rjsears/Pool_Fill_Control/pictures/atlas_usb_ph_orp_interface.jpg

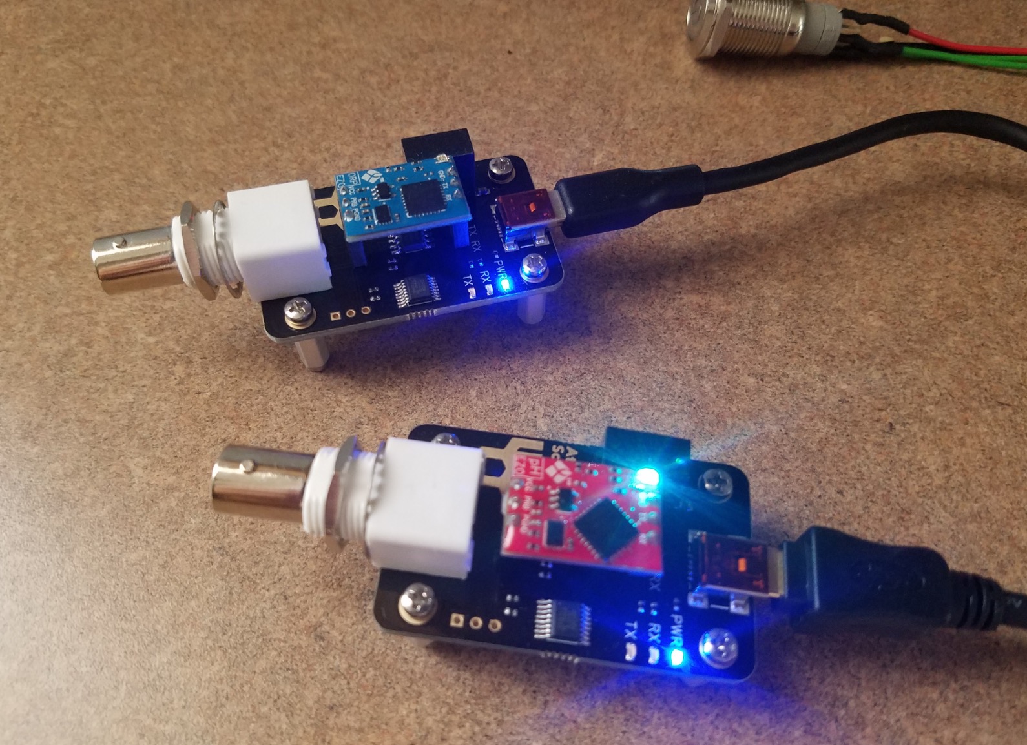
pictures/atlas_usb_ph_orp_interface.jpg
