rjsears/Pool_Fill_Control/pictures/bb_mockup.jpg

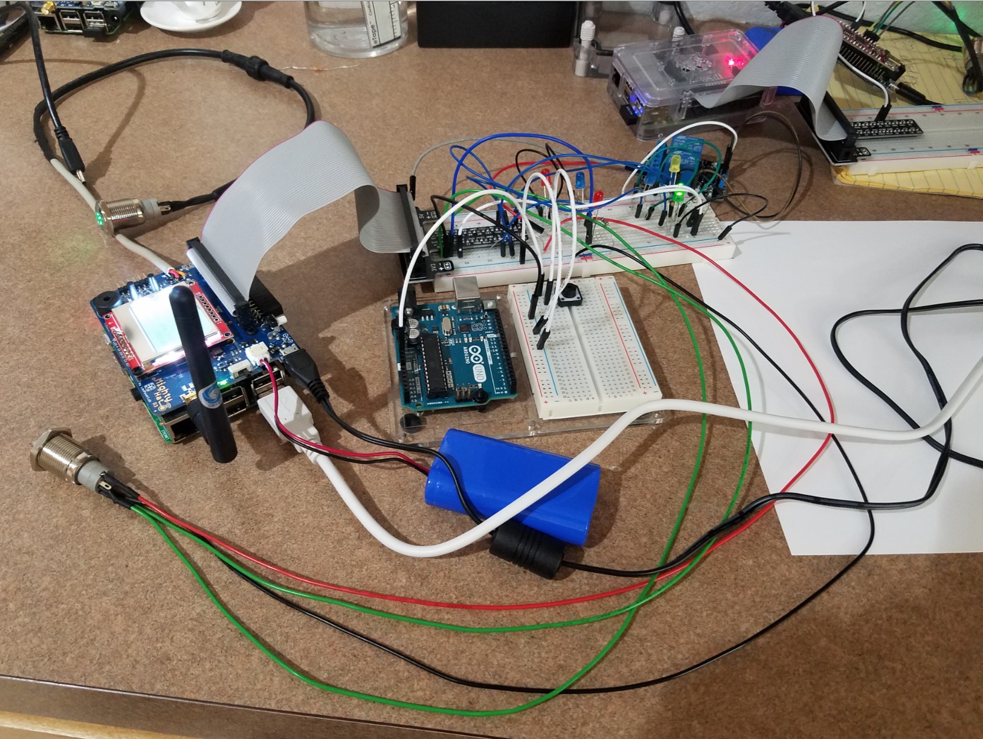
pictures/bb_mockup.jpg
