rjsears/Pool_Fill_Control/pictures/emonTH.jpg

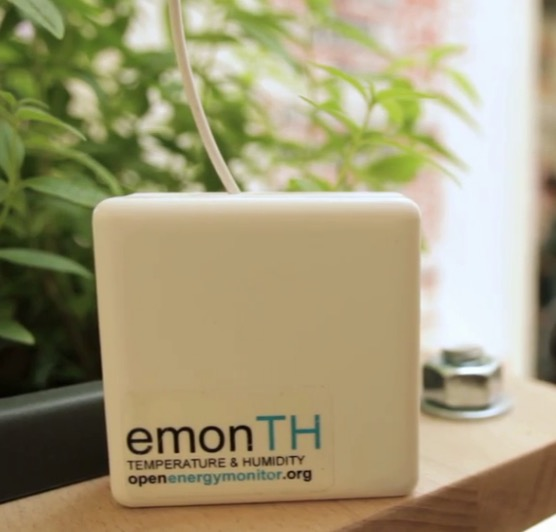
pictures/emonTH.jpg
