rjsears/Pool_Fill_Control/pictures/etape.jpg

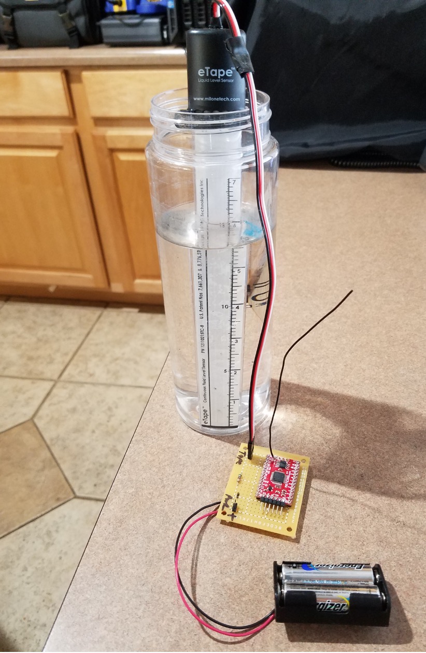
pictures/etape.jpg
