rjsears/Pool_Fill_Control/pictures/interface_board_back.jpg

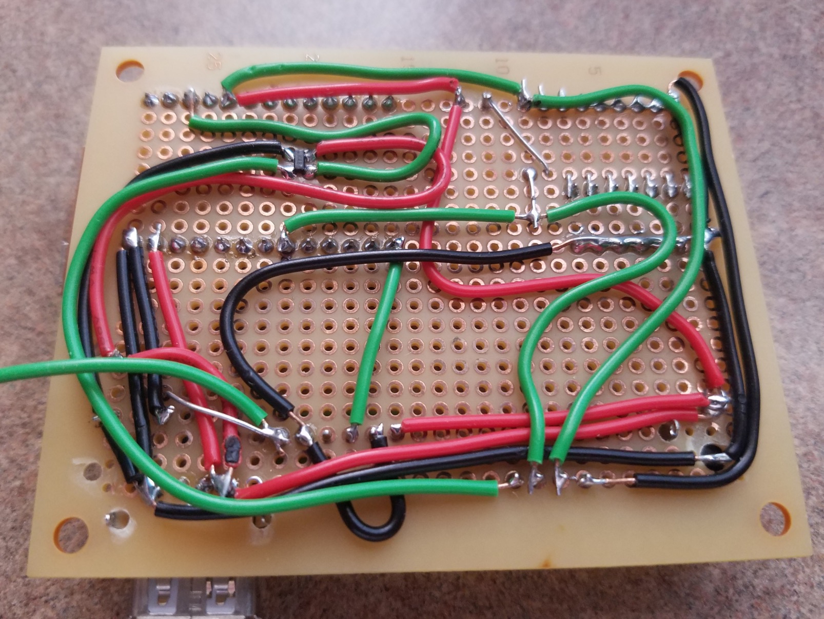
pictures/interface_board_back.jpg
