rjsears/Pool_Fill_Control/pictures/interface_board_front.jpg

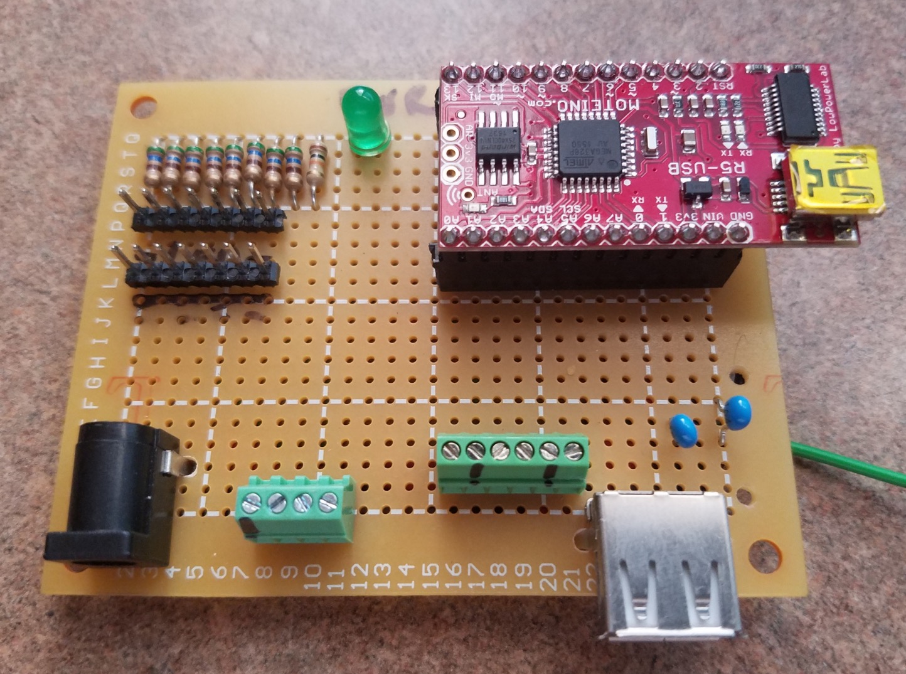
pictures/interface_board_front.jpg
