rjsears/Pool_Fill_Control/pictures/IO_Board_v1.jpg

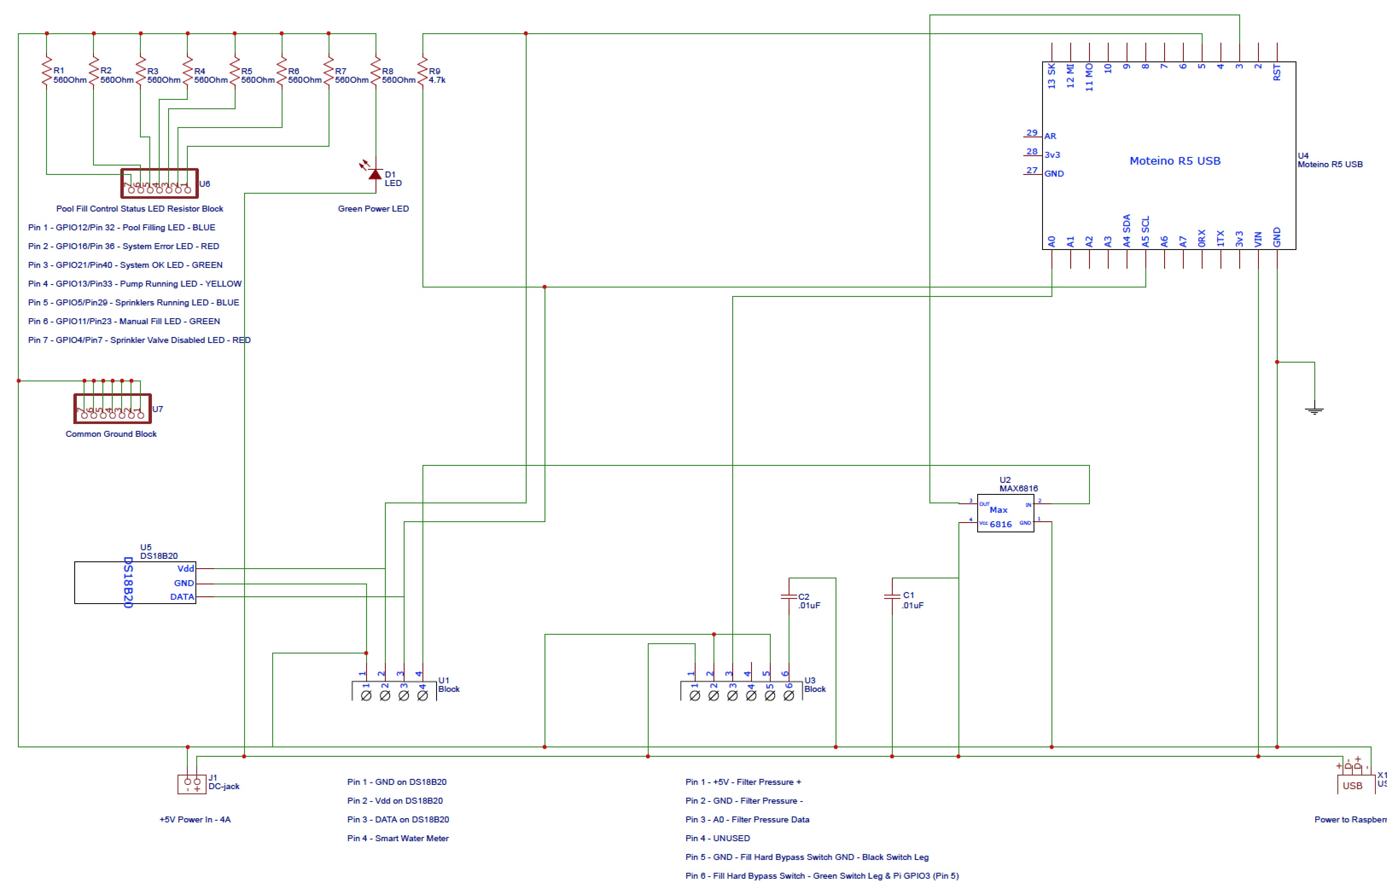
pictures/IO_Board_v1.jpg
