rjsears/Pool_Fill_Control/pictures/PFC_external.jpg

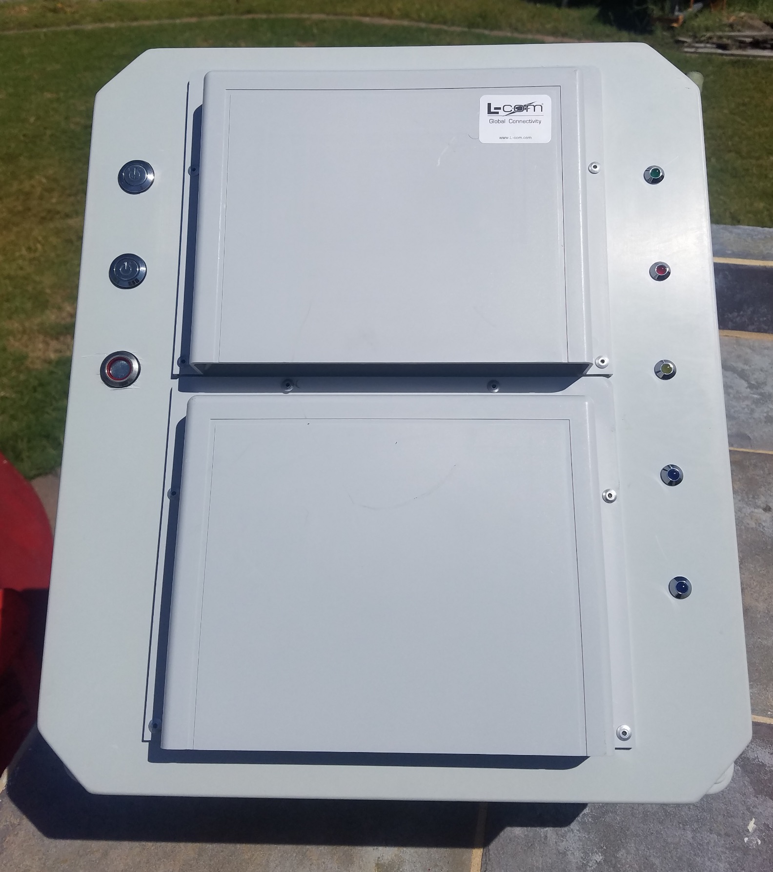
pictures/PFC_external.jpg
