rjsears/Pool_Fill_Control/pictures/PFC_fans.jpg

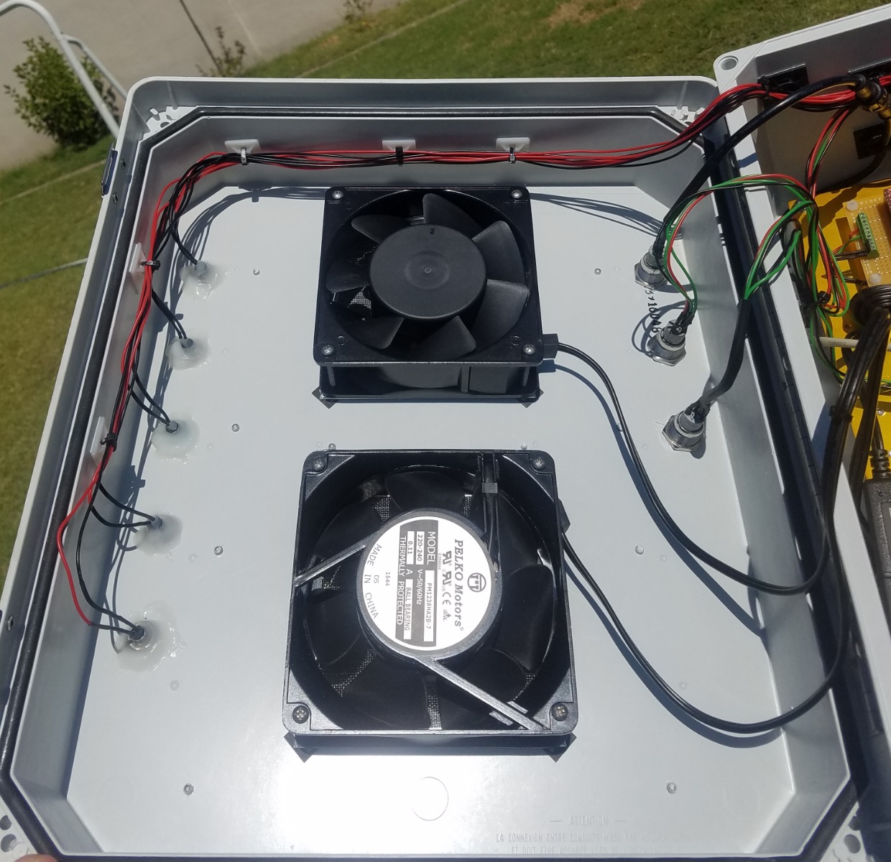
pictures/PFC_fans.jpg
