rjsears/Pool_Fill_Control/pictures/PFC_internal.jpg

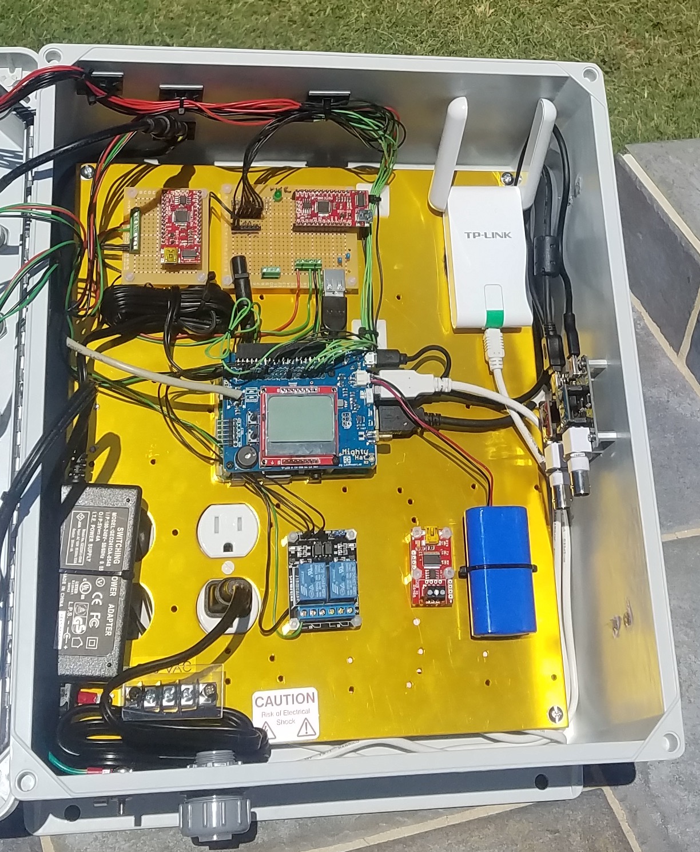
pictures/PFC_internal.jpg
