rjsears/Pool_Fill_Control/pictures/PFC_lights.jpg

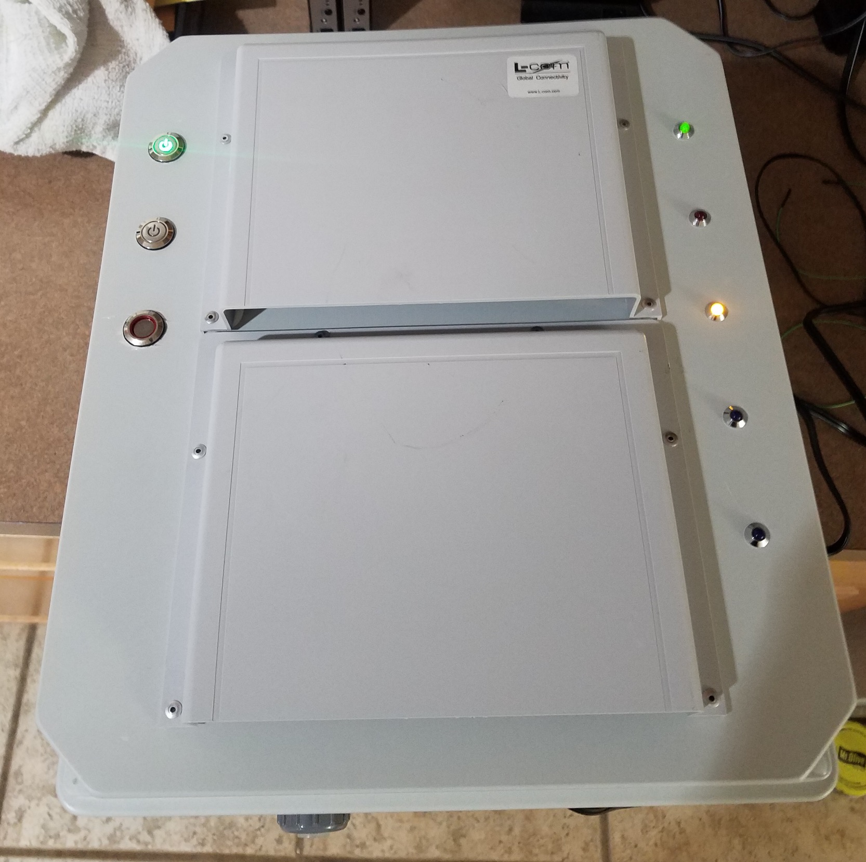
pictures/PFC_lights.jpg
