rjsears/Pool_Fill_Control/pictures/pool_control_web_interface_v32.jpg

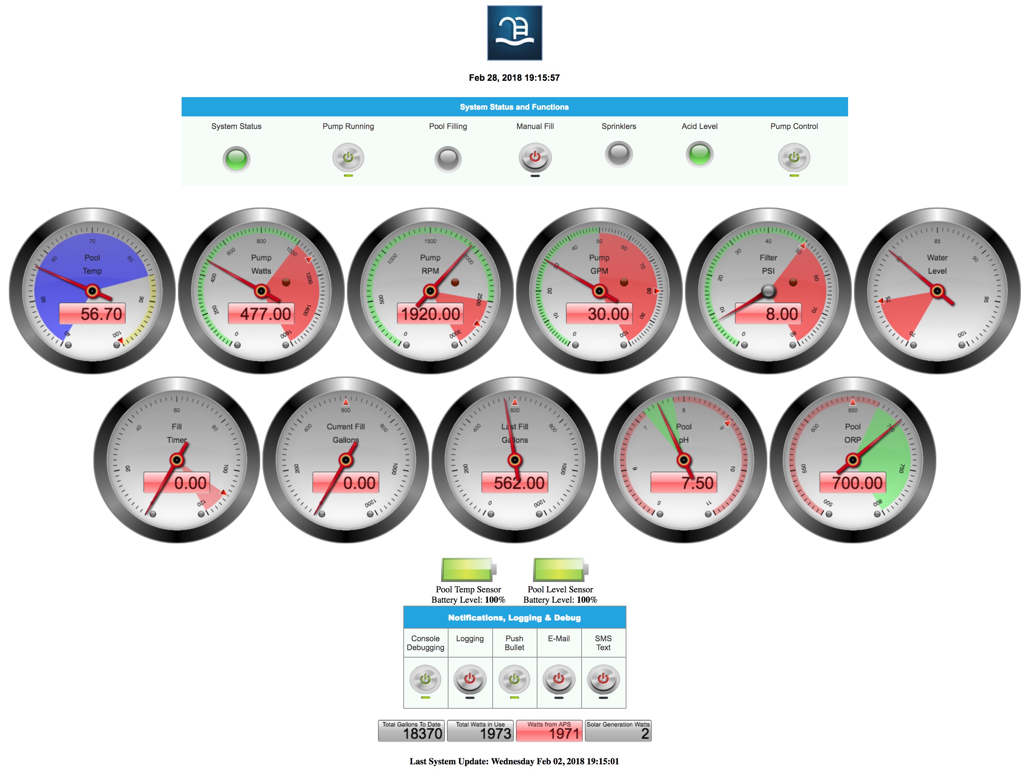
pictures/pool_control_web_interface_v32.jpg
