rjsears/Pool_Fill_Control/pictures/pool_fill_valve_complete.jpg

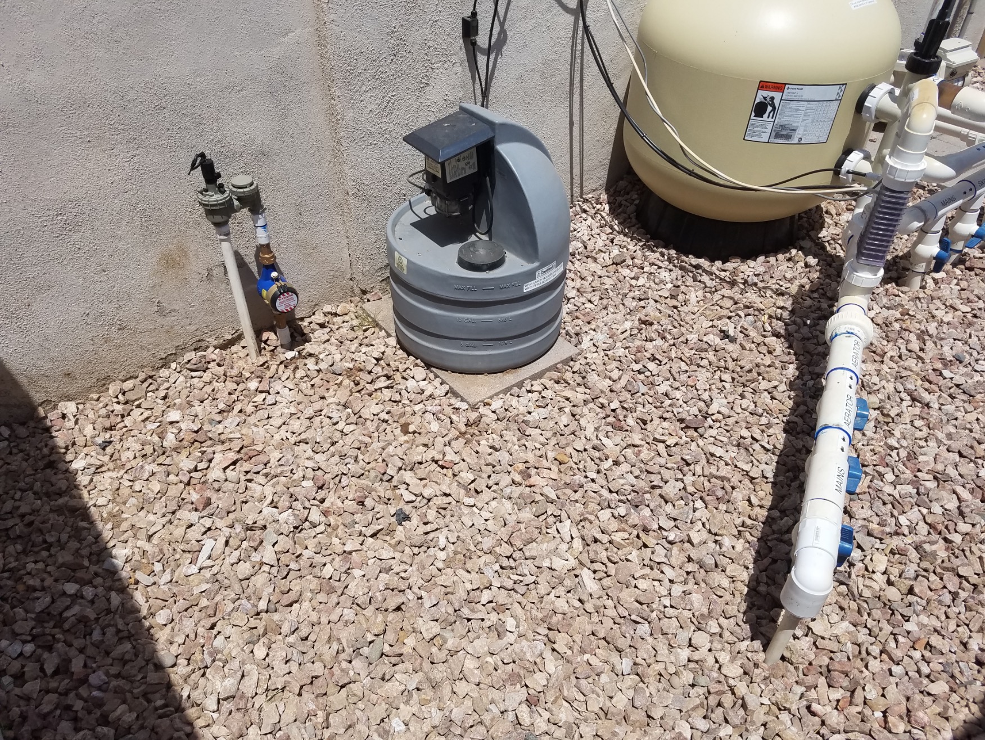
pictures/pool_fill_valve_complete.jpg
