rjsears/Pool_Fill_Control/pictures/pool_fill_valve_in_process1.jpg

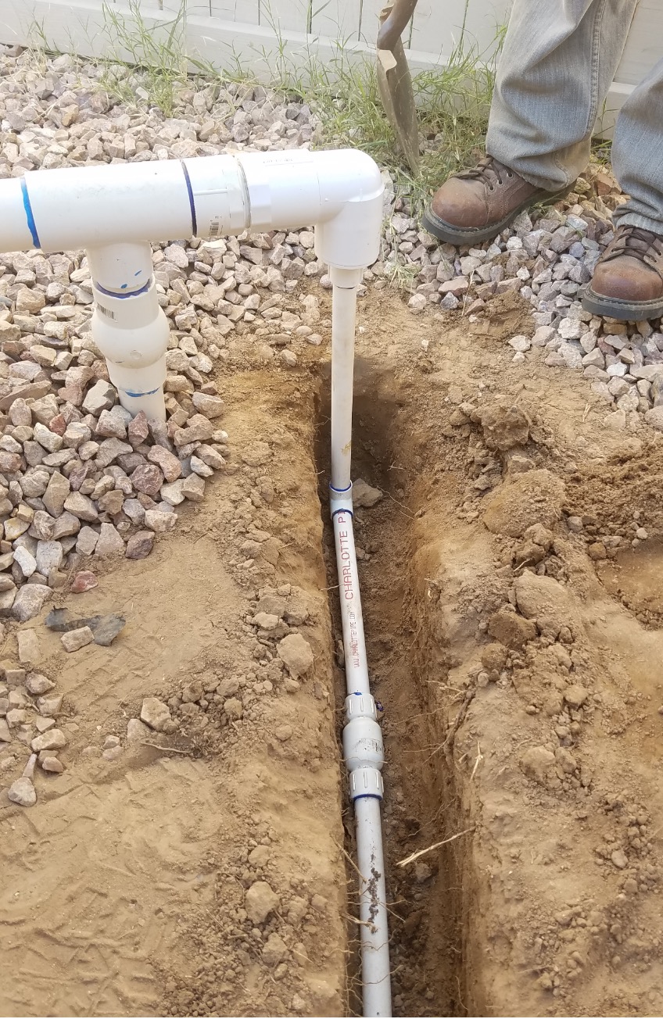
pictures/pool_fill_valve_in_process1.jpg
