rjsears/Pool_Fill_Control/pictures/pool_fill_valve_in_process.jpg

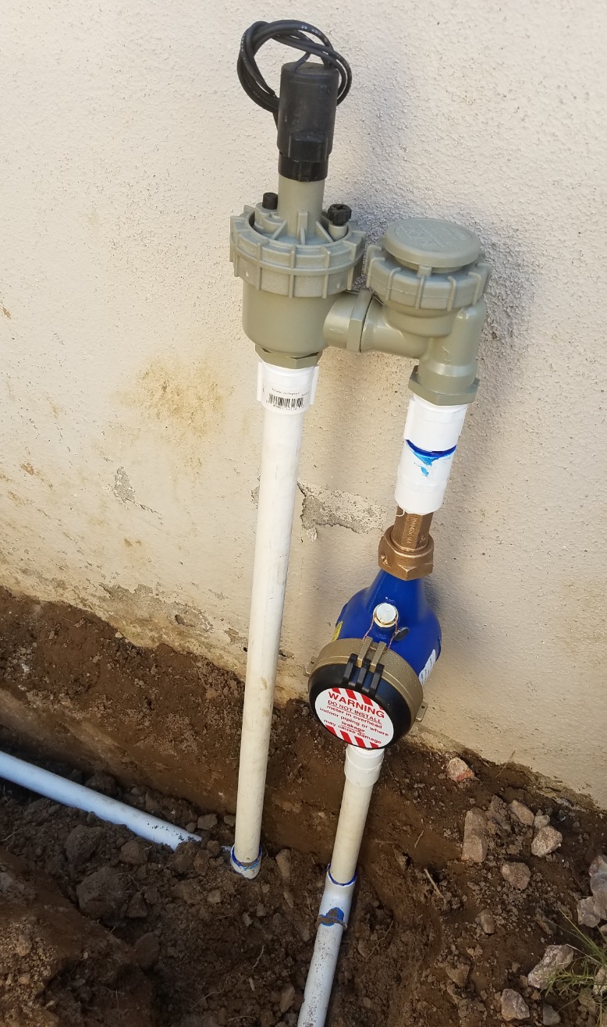
pictures/pool_fill_valve_in_process.jpg
