rjsears/Pool_Fill_Control/pictures/pool_filter_area.jpg

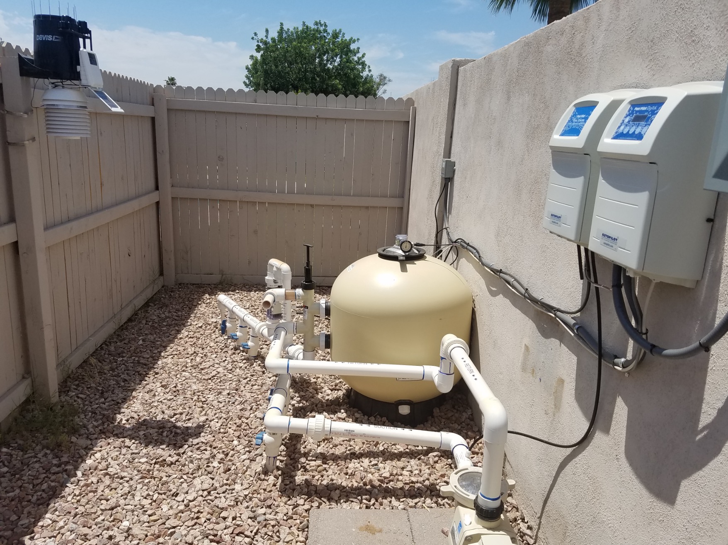
pictures/pool_filter_area.jpg
