rjsears/Pool_Fill_Control/pictures/schematic.jpg

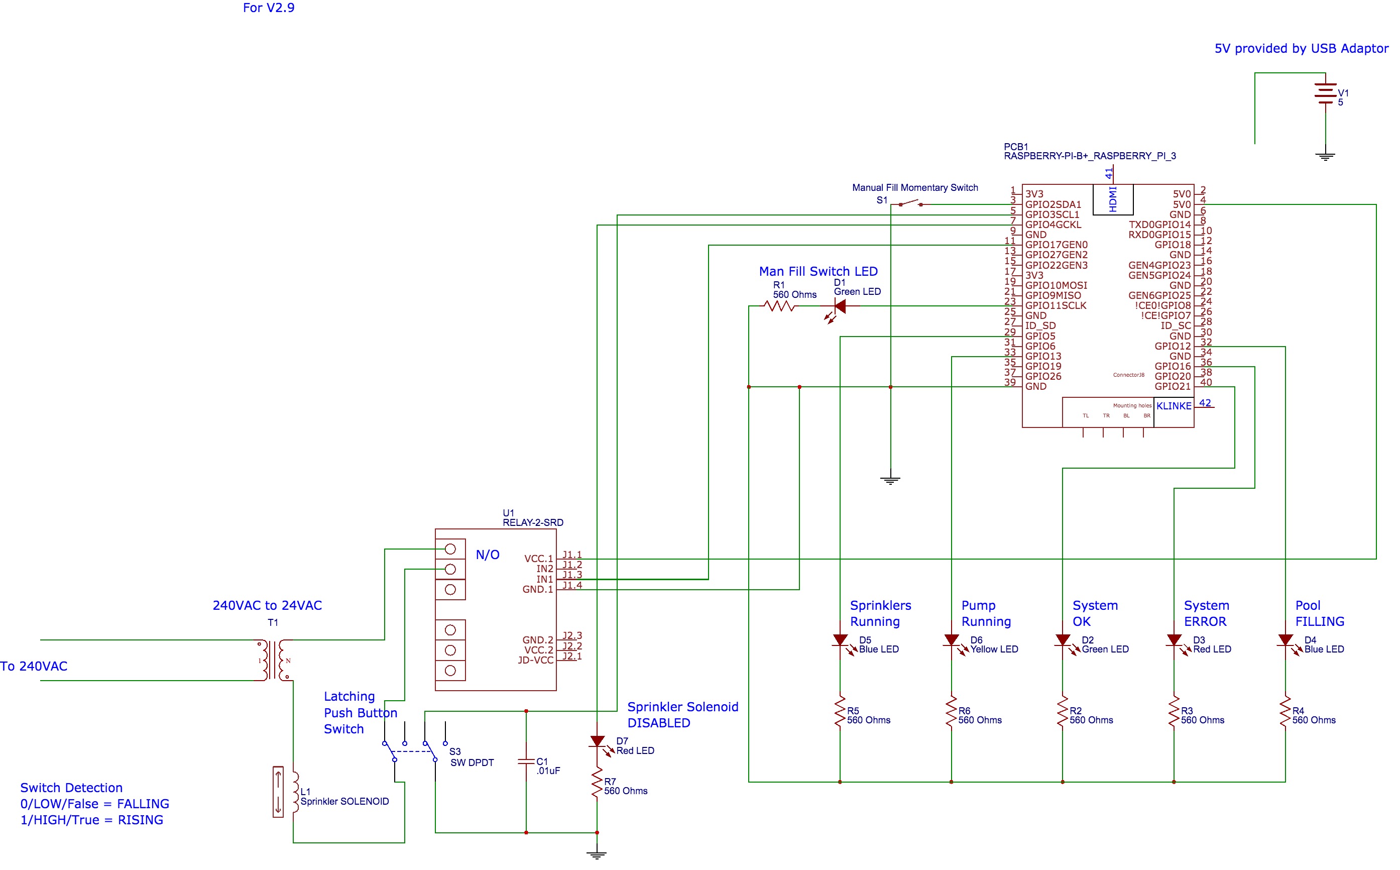
pictures/schematic.jpg
