rjsears/Pool_Fill_Control/pictures/schematic_V2.jpg

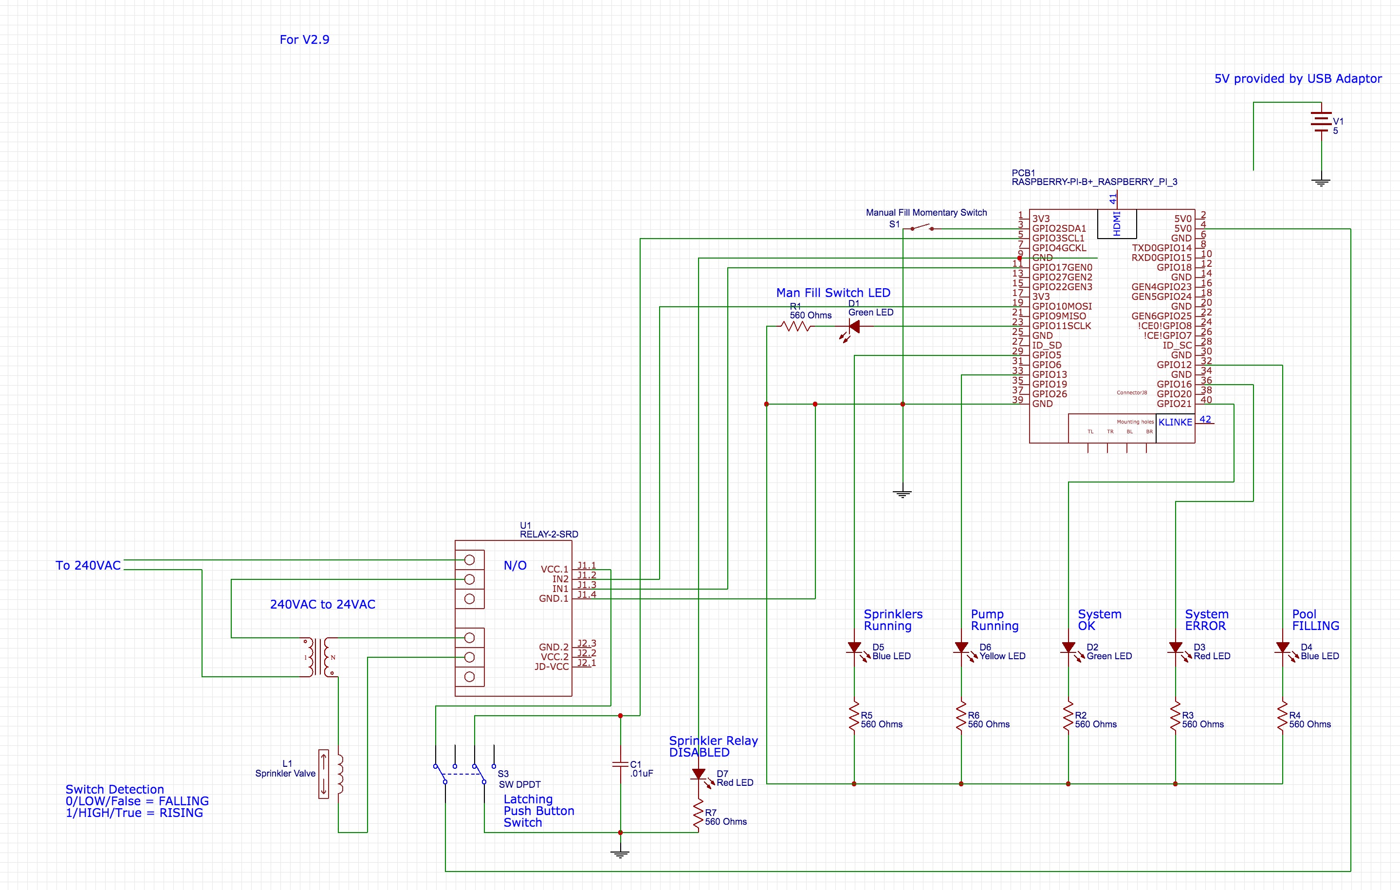
pictures/schematic_V2.jpg
