rjsears/Pool_Fill_Control/pictures/screen 2016-05-30 at 1.51.52 PM.jpg

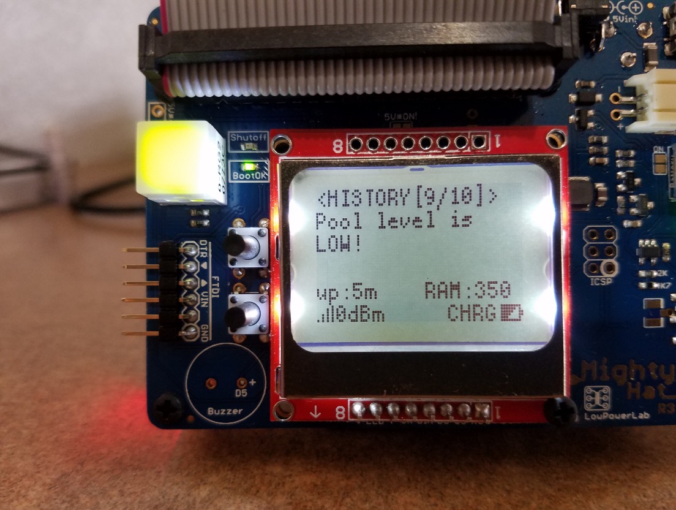
pictures/screen 2016-05-30 at 1.51.52 PM.jpg
