rjsears/Pool_Fill_Control/pictures/screen 2016-05-30 at 1.52.40 PM.jpg

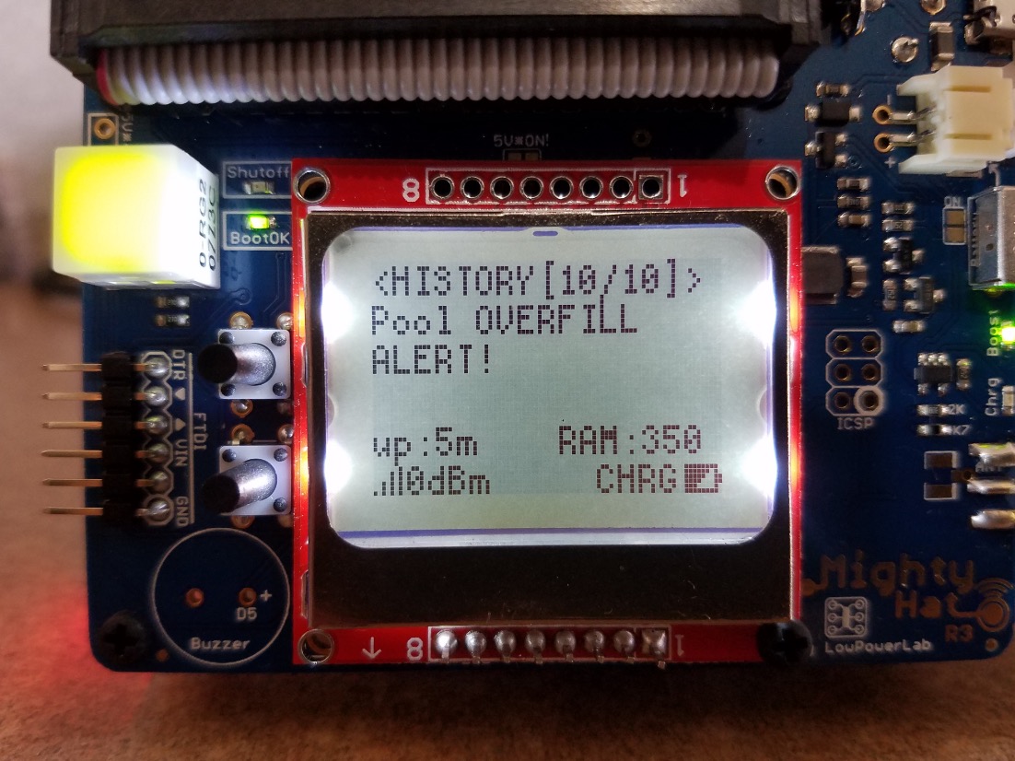
pictures/screen 2016-05-30 at 1.52.40 PM.jpg
