rjsears/Pool_Fill_Control/pictures/Web_interface_V3_4.jpg

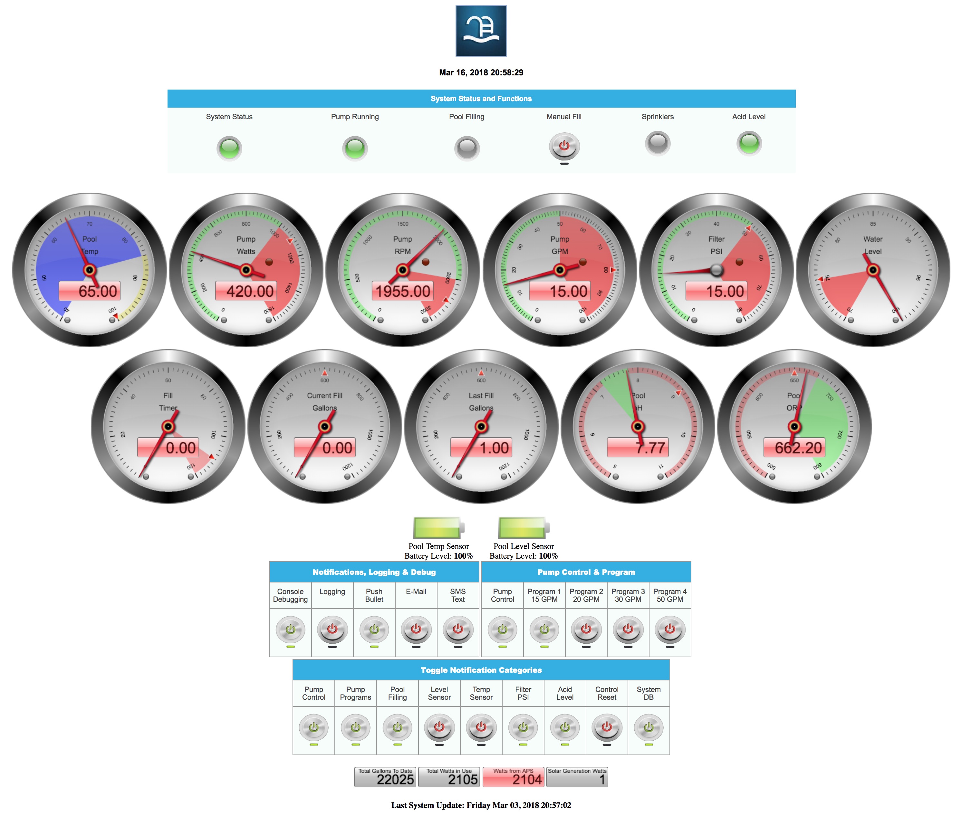
pictures/Web_interface_V3_4.jpg
