rjsears/Pool_Fill_Control/static/dark-red-led-circle-md.png

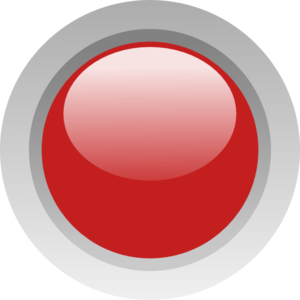
static/dark-red-led-circle-md.png
