rjsears/Pool_Fill_Control/static/off_switch.png

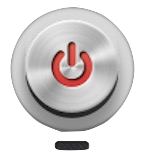
static/off_switch.png
