rjsears/Pool_Fill_Control/static/on_switch.png

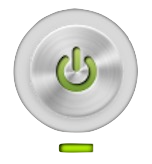
static/on_switch.png
