rjsears/Pool_Fill_Control/pictures/ph_probe_calibration.jpg

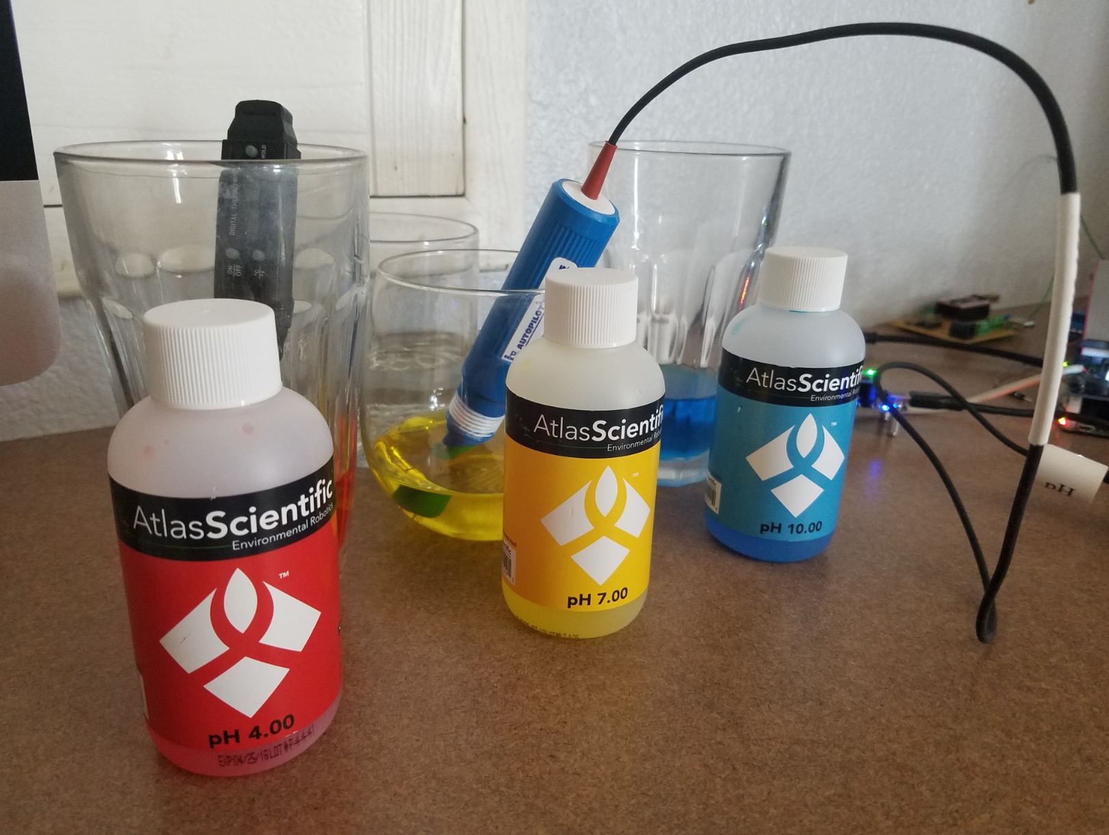
pictures/ph_probe_calibration.jpg
