rjsears/Pool_Fill_Control/(threads)

Thread 4 (2019-03-18):

Question... How do you fill the water and drain it?

gbdavidx, 2019-03-18:
I would love to automate my pool more (determine if it's low), if i were to just get Elecall stainless steel tank water level sensor, what part of the code would need to be uploaded? and how would i connect the two wires to the low powered arduino board?

Thread 5 (2020-11-12):

Simplified System

Nyholms, 2020-11-12:
RJ Sears,
I would like to control an IntelliFlow VS-3050 on my DIY pool system directly with an Arduino (preferred method) or a Raspberry Pi (2nd choice method). My user interface will be via OpenHab with communications via MQTT.  Regarding only the pump, my requirements are simple: Control pump On/Off and RPM.  Your outstanding system far exceeds my needs.  Can you point me to the appropriate software module(s) that are need for my simple system?
Thanks

Thread 6 (2021-03-31):

EmonPi required to communicate to emonCMS ?

jaim-fads, 2021-03-31:
Hi Richard,
I'd like to utilize the water level sensor portion of your project. I am new to the home automation/arduino world so I figured I would start small lol. I put together the moteino transceiver, got the eTape, set up an account with emonCMS and downloaded the emonCMS API to communicate with HomeAssistant on the rasPi. The glaring question I have at this point is do I need an emonPI to communicate the data from the eTape to emonCMS ? Or is there a Lib/variable allocation in arduino IDE that I missed when I was learning that would allow for direct communication to emonCMS.org ?

Fun project/Enjoying the process!
Jamie

rjsears, 2021-04-01:
Hi Jamie -

Not necessarily the EmonPi unit but "something" has to receive the reply from the motenio, it can be another mote connected to the serial input on a Pi running the emonCMS software. The EmonPi is essentially a RPi with a 433Mhz (or whatever freq you are using) receiver on it that listens for the transmissions from your motes and dumps it out the serial port on the pi to software (EmonCMS) listening there. I use the EmonPi to help support their project but I also use several of the MightyHats (https://lowpowerlab.com/guide/mightyhat/) with the builtin radio to do the same thing.

You have the transmitter side, not you need the receiver! Hope this helps. If not, feel free to ask more questions.
