rjsears/Pool_Fill_Control/pool_fill_control_schematic.pdf

## 5V provided by USB Adaptor

## For V2.7

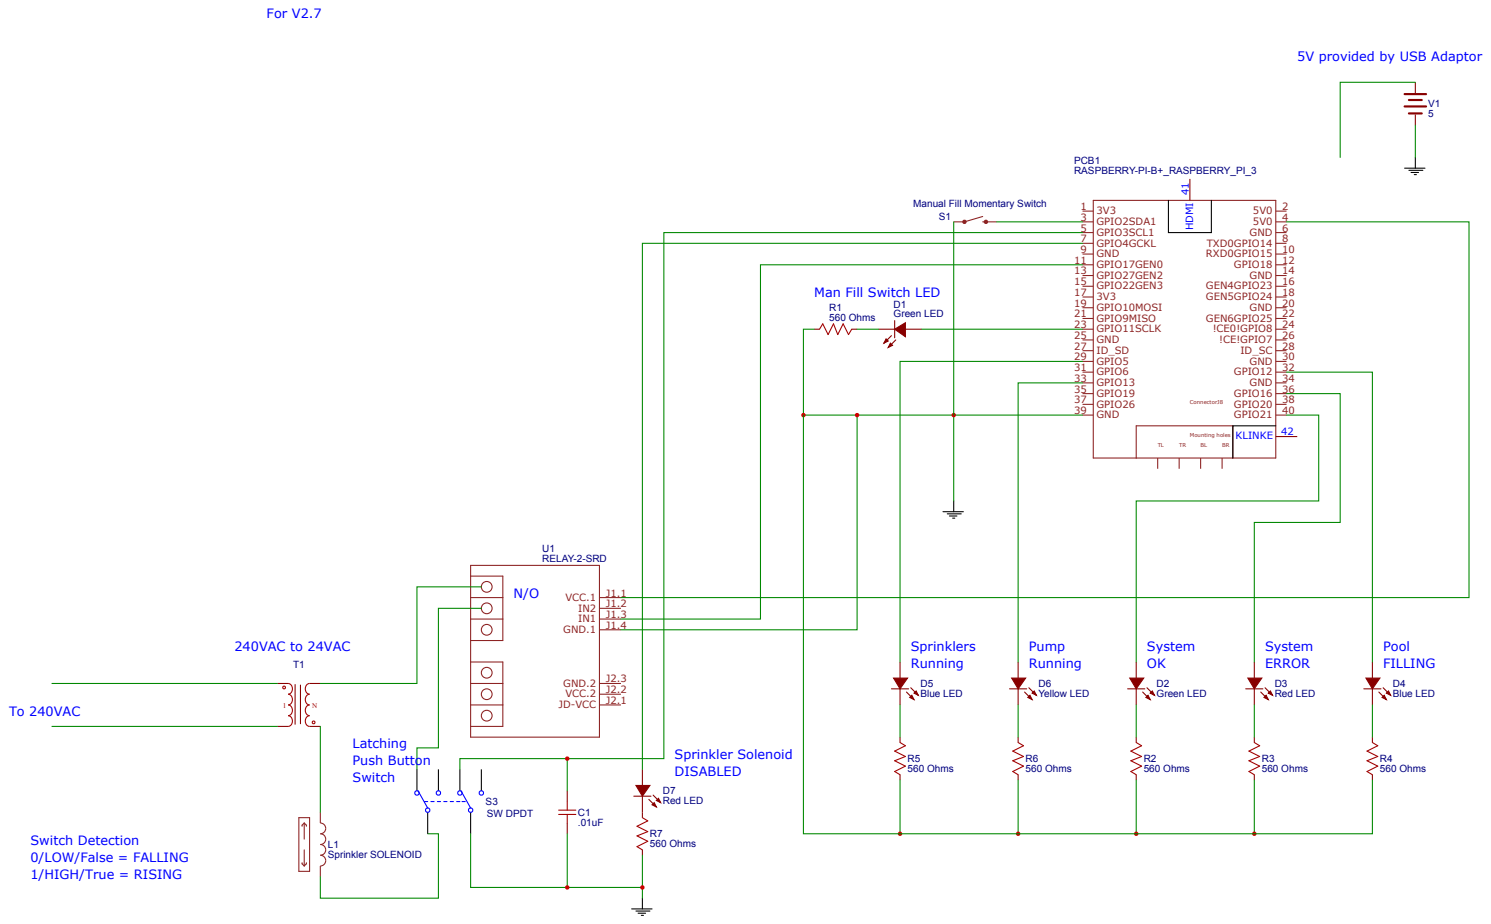
[picture p35: page 1]

Manual Fill Momentary Switch S1

Man Fill Switch LED

Switch Detection 0/LOW/False = FALLING
