rjsears/Pool_Fill_Control/IO_Board_V2.pdf

## 5V provided by USB Adaptor

## For V2.9

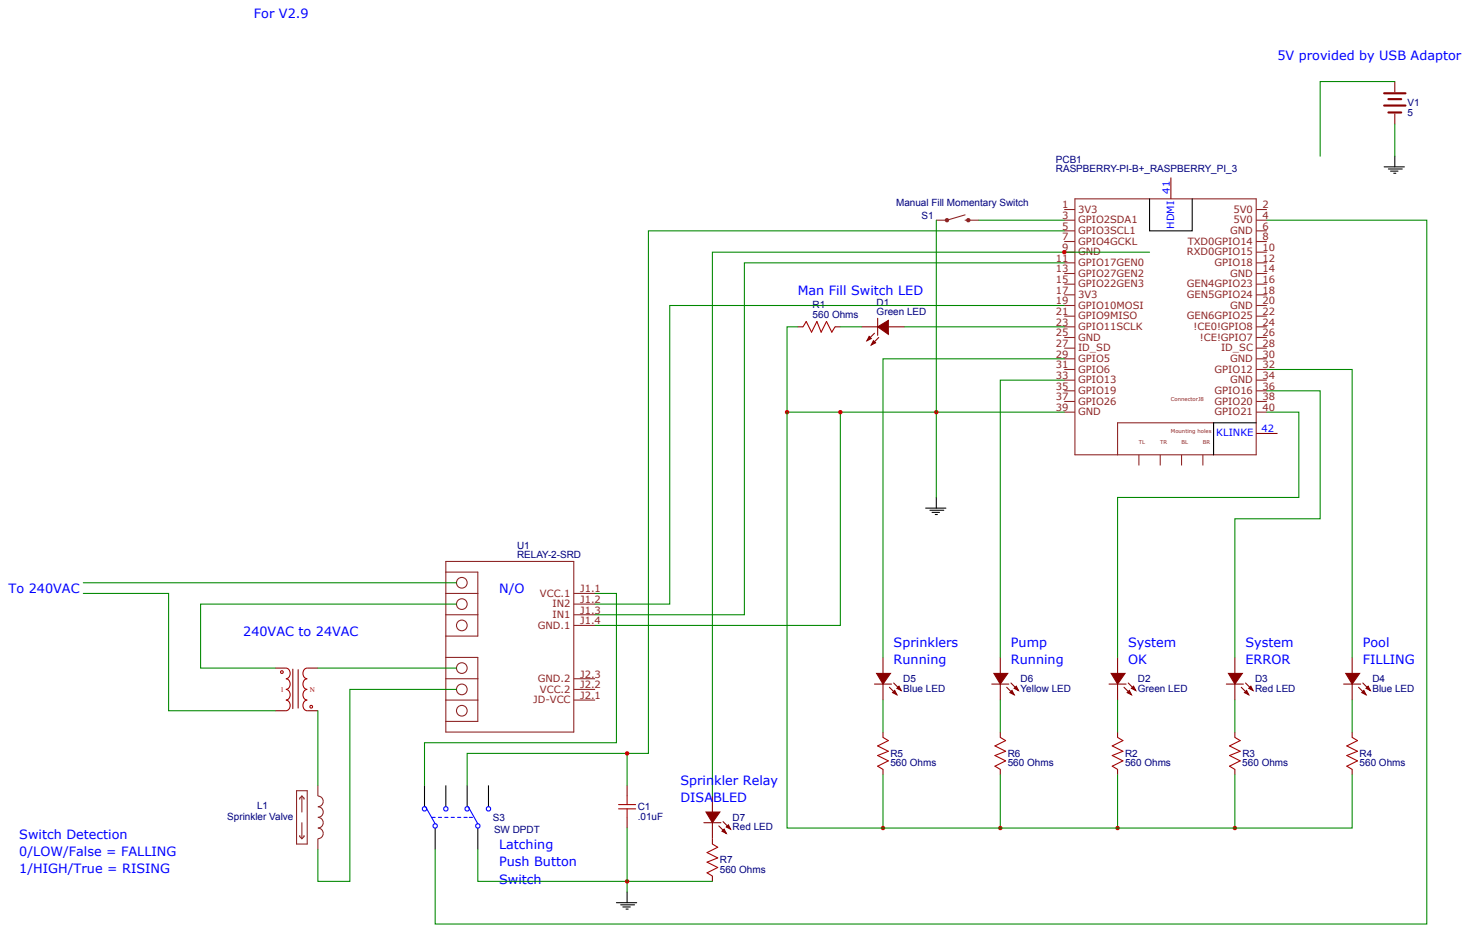
[picture p36: page 1]

Manual Fill Momentary Switch S1

Man Fill Switch LED

Switch Detection 0/LOW/False = FALLING
