rjsears/Pool_Fill_Control/(commit log)

2016-05-31 Arduino sketch for MightyHat
2016-06-04 Updated LED sequences to work with new LED button
2016-06-04 Added 5 system status LEDs, updated manual fill check
2016-06-04 Wiring schematic for pool_fill_control Pi/MightyHat
2016-06-04 Changed layout of resistors for LEDs
2016-06-05 Added new switch and LED
2016-06-05 V2.5 Bug Fixes plus Manual Interrupt Switch
2016-06-05 Updated to add additional switch and LED
2016-06-05 Added code for Manual Fill interrupt switch
2016-06-12 Added .01uF cap to latching switch for debounce
2016-06-20 IO Board Schematic
2017-03-02 Added Pool_Fill_Control Flow Chart
2017-03-02 Update Pool_Fill_Control Flow Chart
2017-10-01 Create moteino-r5_DS18B20_PSI_RFM69HW_RJS-Pool_Control_Box.ino
    Sketch that runs one of my Moteino R5s (Arduino clone) in my pool control box. This sketch takes temperature readings from a DS18B20 inside the box so I can monitor internal temperatures and it also reads my filter pressure PSI utilizing a 0-100 PSI pressure sensor on my filter.
2017-10-22 Manual check of sensors via cron or cli
2018-02-28 Added pump control
2018-03-01 added power DB feeds
2018-03-01 Added power monitoring
2018-03-17 added solar, Ph, ORP, pump status
