rjsears/Pool_Fill_Control/(notices)

Notices in the files:
MightyHat.ino:
Public License as published by the Free Software
Public License along with this program.
